mboroff/Arduino_Integrated_Amateur_Station_Accessories/README.md

# Arduino_Integrated_Amateur_Station_Accessories
#
# My integrated accessories consist of a PS/2 Keyboard CW encoder, a Station Clock, a Morse Code Decoder and a QSO logger.
