mboroff/Arduino_Integrated_Amateur_Station_Accessories/Switched_Simple_Morse_Code_Decoder_V2/Switched_Simple_Morse_Code_Decoder_V2.ino

///////////////////////////////////////////////////////////////////////
// CW Decoder made by Hjalmar Skovholm Hansen OZ1JHM  VER 1.01       //
// Feel free to change, copy or what ever you like but respect       //
// that license is http://www.gnu.org/copyleft/gpl.html              //
// Discuss and give great ideas on                                   //
// https://groups.yahoo.com/neo/groups/oz1jhm/conversations/messages //
///////////////////////////////////////////////////////////////////////

///////////////////////////////////////////////////////////////////////////
// Read more here http://en.wikipedia.org/wiki/Goertzel_algorithm        //
// if you want to know about FFT the http://www.dspguide.com/pdfbook.htm //
///////////////////////////////////////////////////////////////////////////


const int colums = 20; /// have to be 16 or 20
const int rows = 4;  /// have to be 2 or 4

int lcdindex = 0;
int line1[colums];
int line2[colums];


int audioInPin = A2;
int ledPin = 13;
#define switchPin 4

int switchState;
float magnitude ;
int magnitudelimit = 100;
int magnitudelimit_low = 100;
int realstate = LOW;
int realstatebefore = LOW;
int filteredstate = LOW;
int filteredstatebefore = LOW;


///////////////////////////////////////////////////////////
// The sampling frq will be 8928 on a 16 mhz             //
// without any prescaler etc                             //
// because we need the tone in the center of the bins    //
// you can set the tone to 496, 558, 744 or 992          //
// then n the number of samples which give the bandwidth //
// can be (8928 / tone) * 1 or 2 or 3 or 4 etc           //
// init is 8928/558 = 16 *4 = 64 samples                 //
// try to take n = 96 or 128 ;o)                         //
// 48 will give you a bandwidth around 186 hz            //
// 64 will give you a bandwidth around 140 hz            //
// 96 will give you a bandwidth around 94 hz             //
// 128 will give you a bandwidth around 70 hz            //
// BUT remember that high n take a lot of time           //
// so you have to find the compromice - i use 48         //
///////////////////////////////////////////////////////////

float coeff;
float Q1 = 0;
float Q2 = 0;
float sine;
float cosine;  
float sampling_freq=8928.0;
//float target_freq=558.0; /// adjust for your needs see above
float target_freq=700.0; /// adjust for your needs see above
float n=48.0;  //// if you change  her please change next line also 
int testData[48];

//////////////////////////////
// Noise Blanker time which //
// shall be computed so     //
// this is initial          //
//////////////////////////////
int nbtime = 6;  /// ms noise blanker         

long starttimehigh;
long highduration;
long lasthighduration;
long hightimesavg;
long lowtimesavg;
long startttimelow;
long lowduration;
long laststarttime = 0;

char code[20];
int stop = LOW;
int wpm;
char lcdBuff[21] = "                    ";
char lcdGuy;

////////////////
// init setup //
////////////////
void setup() {

////////////////////////////////////
// The basic goertzel calculation //
////////////////////////////////////
  int	k;
  float	omega;
  k = (int) (0.5 + ((n * target_freq) / sampling_freq));
  omega = (2.0 * PI * k) / n;
  sine = sin(omega);
  cosine = cos(omega);
  coeff = 2.0 * cosine;
 Serial.begin(38400); 
 pinMode(ledPin, OUTPUT); 
 pinMode(switchPin, INPUT);
  
}

///////////////
// main loop //
///////////////
 void loop() {

   int switchState = digitalRead(switchPin);
   if (switchState < 0) {
       switchState = HIGH;
   }
   if (switchState == LOW) {
       digitalWrite(ledPin, LOW);
   }
 while(switchState == HIGH) {
   switchState =    digitalRead(switchPin);
   
  ///////////////////////////////////// 
  // The basic where we get the tone //
  /////////////////////////////////////
  
  for (char index = 0; index < n; index++)
  {
    testData[index] = analogRead(audioInPin);
  }
  for (char index = 0; index < n; index++){
	  float Q0;
	  Q0 = coeff * Q1 - Q2 + (float) testData[index];
	  Q2 = Q1;
	  Q1 = Q0;	
  }
  float magnitudeSquared = (Q1*Q1)+(Q2*Q2)-Q1*Q2*coeff;  // we do only need the real part //
  magnitude = sqrt(magnitudeSquared);
  Q2 = 0;
  Q1 = 0;

   
  /////////////////////////////////////////////////////////// 
  // here we will try to set the magnitude limit automatic //
  ///////////////////////////////////////////////////////////
  
  if (magnitude > magnitudelimit_low){
    magnitudelimit = (magnitudelimit +((magnitude - magnitudelimit)/6));  /// moving average filter
  }
 
  if (magnitudelimit < magnitudelimit_low)
	magnitudelimit = magnitudelimit_low;
  
  ////////////////////////////////////
  // now we check for the magnitude //
  ////////////////////////////////////

  if(magnitude > magnitudelimit*0.6) // just to have some space up 
     realstate = HIGH; 
  else
    realstate = LOW; 
  
  ///////////////////////////////////////////////////// 
  // here we clean up the state with a noise blanker //
  /////////////////////////////////////////////////////
 
  if (realstate != realstatebefore){
	laststarttime = millis();
  }
  if ((millis()-laststarttime)> nbtime){
	if (realstate != filteredstate){
		filteredstate = realstate;
	}
  }
 
 ////////////////////////////////////////////////////////////
 // Then we do want to have some durations on high and low //
 ////////////////////////////////////////////////////////////
 
 if (filteredstate != filteredstatebefore){
	if (filteredstate == HIGH){
		starttimehigh = millis();
		lowduration = (millis() - startttimelow);
	}

	if (filteredstate == LOW){
		startttimelow = millis();
		highduration = (millis() - starttimehigh);
        if (highduration < (2*hightimesavg) || hightimesavg == 0){
			hightimesavg = (highduration+hightimesavg+hightimesavg)/3;     // now we know avg dit time ( rolling 3 avg)
		}
		if (highduration > (5*hightimesavg) ){
			hightimesavg = highduration+hightimesavg;     // if speed decrease fast ..
		}
	}
  }

 ///////////////////////////////////////////////////////////////
 // now we will check which kind of baud we have - dit or dah //
 // and what kind of pause we do have 1 - 3 or 7 pause        //
 // we think that hightimeavg = 1 bit                         //
 ///////////////////////////////////////////////////////////////
 
 if (filteredstate != filteredstatebefore){
  stop = LOW;
  if (filteredstate == LOW){  //// we did end a HIGH
   if (highduration < (hightimesavg*2) && highduration > (hightimesavg*0.6)){ /// 0.6 filter out false dits
	strcat(code,".");
   }
   if (highduration > (hightimesavg*2) && highduration < (hightimesavg*6)){ 
	strcat(code,"-");
	wpm = (wpm + (1200/((highduration)/3)))/2;  //// the most precise we can do ;o)
   }
  }
 
   if (filteredstate == HIGH){  //// we did end a LOW
   
   float lacktime = 1;
   if(wpm > 25)lacktime=1.0; ///  when high speeds we have to have a little more pause before new letter or new word 
   if(wpm > 30)lacktime=1.2;
   if(wpm > 35)lacktime=1.5;
   
   if (lowduration > (hightimesavg*(2*lacktime)) && lowduration < hightimesavg*(5*lacktime)){ // letter space
    docode();
	code[0] = '\0';
   }
   if (lowduration >= hightimesavg*(5*lacktime)){ // word space
    docode();
	code[0] = '\0';
	printascii(32);
   }
  }
 }
 
 //////////////////////////////
 // write if no more letters //
 //////////////////////////////

  if ((millis() - startttimelow) > (highduration * 6) && stop == LOW){
   docode();
   code[0] = '\0';
   stop = HIGH;
  }

 /////////////////////////////////////
 // we will turn on and off the LED //
 // and the speaker                 //
 /////////////////////////////////////
 
   if(filteredstate == HIGH){ 
     digitalWrite(ledPin, HIGH);
//	 tone(audioOutPin,target_freq);
   }
   else{
     digitalWrite(ledPin, LOW);
//	 noTone(audioOutPin);
   }
 
 //////////////////////////////////
 // the end of main loop clean up//
 /////////////////////////////////
 realstatebefore = realstate;
 lasthighduration = highduration;
 filteredstatebefore = filteredstate;
 }
}

////////////////////////////////
// translate cw code to ascii //
////////////////////////////////

void docode() {
  static char alphaSet[] = "##TEMNAIOGKDWRUS##QZYCXBJP#L#FVH09#8###7#####/-61#######2###3#45";
  int sum;
  int len = strlen(code);
  
  sum = 1 << len;                                // Sentinel bit set
  len--;                                         // Bits remaining to inspect
  if (len >= 0) { 
  for (int i = 0; i <= len; i++) {                   // Loop through those bits
      if (code[i] == '.') {                        // If a dit, treat a binary value, base 2
        sum += 1 << (len - i);
      }
    }
    if (sum > sizeof(alphaSet)) {                    // If outside of Alpha array, must be punctuation
      printPunctuation(sum);  // The value we parsed is bigger than our character array
    } else {
     printascii(alphaSet[sum]);
    }
  }
}

/////////////////////////////////////
// print the ascii code to the lcd //
// one a time so we can generate   //
// special letters                 //
/////////////////////////////////////
void printascii(int asciinumber){

Serial.write(asciinumber); 
//Serial.println();
}

/*****
  Punctuation marks are made up of more dits and dahs than letters and numbers.
  Rather than extend the character array out to reach these higher numbers we
  will simply check for them here. This funtion only gets called when sum is
  greater than the sizeof the alphaSet[] array.

  Parameter List:
    int val        the value of the index after bit shifting

  Return value:
    void
*****/
void printPunctuation(int val) {
  lcdGuy = val;
  switch (val) {
    case 71:
      lcdGuy = ':';
      break;
    case 76:
      lcdGuy = ',';
      break;
    case 84:
      lcdGuy = '!';
      break;
    case 94:
      lcdGuy = '-';
      break;
    case 97:
      lcdGuy = 39;    // Apostrophe
      break;
    case 101:
      lcdGuy = '@';
      break;
    case 106:
      lcdGuy = '.';
      break;
    case 115:
      lcdGuy = '?';
      break;
    case 246:
      lcdGuy = '$';
      break;
    case 122:
      lcdGuy = 's';
      printascii(lcdGuy);
      lcdGuy = 'k';
      break;
    default:
      lcdGuy = ' ';    // Should not get here
      break;
  }
  
  printascii(lcdGuy);
}
